fguiet/water-meter-v2/(commit log)

2020-09-20 Update README.md
    add link to current issue
2020-09-26 add sensor accuracy elements
2020-12-29 version 2.7 - Move to PlatformIO, Improve battery voltage reading
